Sanal-Sivakumar/Drishti/(commit log)

2026-10-14 feat(repo): relocate documentation to root and switch license to GPLv3
2026-10-14 feat(hal): implement hardware abstraction layer and core configuration schemas
    [hardware_dev.yaml, hardware_pi5.yaml]
2026-10-14 feat(hal): integrate direct V4L2 physical camera and ALSA hardware audio sinks
2026-10-14 docs(repo): update milestone progress, hardware streaming modes, and operational ledgers
2026-10-15 fix(currency): eliminate false positive announcements with edge texture density gating and user intent triggers
    [run_live_wearable.py]
2026-10-15 fix(hal): prevent aplay zombie leaks and bounded audio recorder with auto camera fallback
    [audio_output.py, camera.py, distance_sensor.py, trigger_input.py]
2026-10-15 feat(pipeline): wire centralized YAML configuration and production wearable live runner
2026-10-15 docs: synchronize root documentation and operational ledger with production architecture
2026-10-15 fix(ci): ensure deterministic synthetic OCR extraction and add verified model mirrors with strict exit validation
    [download_models.py]
2026-10-15 fix(core): replace fragile class checks, implement structured logging, add model sha256 verification and process lifecycle cleanup
    [audio_output.py, camera.py, distance_sensor.py, download_models.py]
2026-11-07 feat(hal): integrate ESP32 sensor link, Piper TTS, parallax depth fusion, and debug viewer
    [hardware_dev.yaml]
2026-11-07 fix(perception): adaptively denormalize YOLO ONNX bounding boxes and refine camera probe
    [camera.py]
2026-11-07 feat(deploy): add ToF zero-offset calibration, Pi 5 setup script, and unified ESP32 support
2026-11-07 fix(firmware): configure PlatformIO src_dir and read Pololu VL53L0X status register
    [drishti_tof.ino]
2026-11-07 docs(firmware): add visual breadboard wiring diagram to WIRING.md
2026-11-07 fix(firmware): auto-reconnect I2C and refine Pololu range status validation
    [drishti_tof.ino]
2026-11-07 fix(pipeline): allow explicit serial port to enable esp32 on laptop hardware
    [run_live_wearable.py]
2026-11-07 fix(firmware): set 33ms long-range timing budget, auto-clear interrupt, and add live calibration feedback
    [calibrate_tof.py, drishti_tof.ino]
2026-11-07 hardware integration modifications
    [hardware_dev.yaml]
2026-11-08 docs(handover): update system state, documentation index, and inter-process tuning guide
    [hardware_dev.yaml]
2026-11-08 feat: harden grounded perception and document product roadmap
    [geometry_calibration.yaml, hardware_dev.yaml]
2026-11-09 fix(pipeline): mark bench calibration verified and isolate speech process from terminal sigint
    [pipeline_config.yaml]
2026-11-09 fix(hal,cognitive): enable audio playback without portaudio and add sensor-grounded narration fallback
    [audio_output.py]
2026-11-09 fix(hal): add auto-recovery reset watchdog for esp32 tof hardware timeout
    [esp32_link.py, run_live_wearable.py]
2026-11-09 fix(perception): adjust currency confidence threshold and contour gating for handheld banknotes
    [pipeline_config.yaml]
2026-11-09 feat(pipeline): wire smolvlm2 narrator with deterministic test simulation fast path
2026-11-09 fix(cognition): eliminate currency false positives, add active scanning window, and integrate neural OCR
    [pipeline_config.yaml, run_live_wearable.py]
2026-11-09 feat(cognition): transition to online vision service, 3-button layout, and purge legacy offline modules
2026-11-09 fix(cognition): optimize Gemini vision with gemini-3.1-flash-lite and IPv4 priority
    [pipeline_config.yaml]
2026-11-09 fix(architecture): resolve provider auto-detection, enforce cloud privacy redaction, validate currency, and secure api keys
    [hardware_pi5.yaml]
2026-11-09 feat(wearable): configure physical tactile buttons as sole trigger input and disable keyboard polling by default
    [hardware_dev.yaml]
2026-11-09 fix(vision): bypass Gemini reasoning overhead with thinkingBudget=0 and increase timeout to 20s
    [pipeline_config.yaml]
2026-11-09 fix(anonymizer): prevent false-positive face and plate blurring on books and banknotes
    [run_live_wearable.py]
2026-11-09 feat(ui): add immediate button-press terminal feedback for cloud vision tasks
2026-11-09 docs: modernize and formalize documentation, technical specifications, and troubleshooting ledger
